oddgrd/sumodd/README.md

# Sumodd mini-sumo robot

Sumodd is a mini-sumo robot developed from scratch, including firmware in C, 3D modelling and PCB
design. See competition rules and robot requirements for mini-sumo robots
[here](https://robotex.international/wp-content/uploads/2025/11/Mini-sumo-rules-2025-ENG.pdf).

The idea for this project, the design of the firmware statemachine and some of the hardware
choices were inspired by [`artfulbytes`](https://github.com/artfulbytes) excellent
[youtube series](https://www.youtube.com/watch?v=g9KbXJydf8I) where he made a sumo robot
from scratch. See his project code [here](https://github.com/artfulbytes/nsumo_video).

## Documentation

The schematic and PCB layout KiCad files for the Sumodd motherboard are available in the
[sumodd-hardware repository](https://github.com/oddgrd/sumodd-hardware), with more detailed
documentation of the parts used and their layout on the board.

The 3D model for the sumo robot chassis, armor and other modules are created in Onshape, the
models for the current v03 version are publicly available
[here](https://cad.onshape.com/documents/0d7b7e5228d2e551c364e980/w/8961cb35e7c10a0739c2b909/e/27abdf6ed8f0cca5180f020e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).

Documentation of the robot's core functionality can be found in the docs directory, with scope
captures for illustration.

- [Firmware state machine](docs/state-machine.md)
- [Enemy detection with time of flight sensors](docs/ranging.md)
- [Dohyo border line detection](docs/line-detection.md)
- [Remote start IR signal handling](docs/ir-remote.md)
- [Motor control](docs/motor-control.md)

In addition to the above, we have a simple voltage divider battery voltage monitor, documented
in the [hardware repo](https://github.com/oddgrd/sumodd-hardware#battery-monitor). It will stop the
motors and indicate with a LED if the battery voltage is too low.

## Development

This project uses [`mise`](https://mise.jdx.dev/) to manage tools and commands/tasks. If you'd
rather not use it, inspect the `mise.toml` file to read which tools are required, and which
commands it runs.

For more information on command usage, append --help to a command, e.g. `mise run build --help`.
For an interactive overview of the available commands, run `mise run`.

### Firmware overview

- Our application code and our driver code lives in `app` and `app/drivers`.
- The STM32CubeMX generated source and header files live in `Src` and
`Inc`.
- External libraries live in `external`, at the time of writing it holds a Segger RTT library
git submodule, used for logging in debug builds, ST's VL53L4CD driver and the Unity unit testing
framework.
- Integration/HIL and unit tests live in `tests`.

We use the STM32 HAL to configure and interact with the hardware, and we use the
[STM32CubeMX](https://www.st.com/en/development-tools/stm32cubemx.html) software to generate the
hardware initialization code for GPIO, I2C, ADC etc., as well as the initial CMake configuration.

If you'd like to view or mutate the current configuration in CubeMX, simply initialize a project
from the `sumo.ioc` file in the root of this repo.

### Building

```sh
# Defaults to debug
mise run build

# Alternatively, specify build preset
mise run build release
```

### Flashing

To build, flash the firmware and reset the device:
```sh
# Build preset is required, defaults to debug
mise run flash
```

To build, flash, reset and attach an RTT logger to device:

```sh
# Build preset is required, defaults to debug
mise run launch
```

To reset the device:

```sh
mise run reset
```

To format the C application code with `clang-format`:

```sh
mise run reset
```

To lint the C application code with `cppcheck`:

```sh
mise run lint
```

### Debugging

To debug the firmware, first build it with the debug preset, then install the probe-rs vscode
[extension](https://marketplace.visualstudio.com/items?itemName=probe-rs.probe-rs-debugger).
You can now start a DAP debug session with probe-rs in the vscode debugging tab.

- To launch a new debug session, which flashes first and resets the device, run the VSCode debugger
with the `.vscode/launch.json` "probe-rs launch" configuration.
- Alternatively, to attach a debugger to a running device to inspect the current state, run the VS
Code debugger with the `.vscode/launch.json` "probe-rs attach" configuration

You can also view logs sent over RTT in debug or integration test builds:

```sh
# Build preset is required, defaults to debug
mise run log
```

### Flashing without probe-rs

The mise commands depend on probe-rs. If you don't want to use probe-rs for flashing and resetting,
you can convert the .elf file to an ARM binary, then flash with st-flash, or whichever other method
you prefer:

```sh
# Create the binary
arm-none-eabi-objcopy -O binary build/debug/sumo.elf build/debug/sumo.bin

# Flash it and reset the device
st-flash --reset write  build/debug/sumo.bin 0x08000000
```

## Testing

To run the unity unit tests, run: `mise run test`

To run the HIL tests, connect the device, then repeat the build and flash steps above, but use the
desired integration test cmake preset.

The currently existing integration test presets are:

- test-drive

For example, if you want to build, flash and attach a logger to an integration test, run:

```sh
mise run launch test-drive
```

## Diagrams

[PlantUML](https://plantuml.com/) is used for diagrams, it depends on Java, which mise manages.

To download the jar file for platuml: `mise run plantuml-setup`. The path it downloads to is set
in a mise variable, which may need to be adjusted to your local system.

To generate a UML png: `mise run plantuml-generate`. Defaults to state machine diagram UML.
