oddgrd/sumodd/docs/media/pcb-layout.png

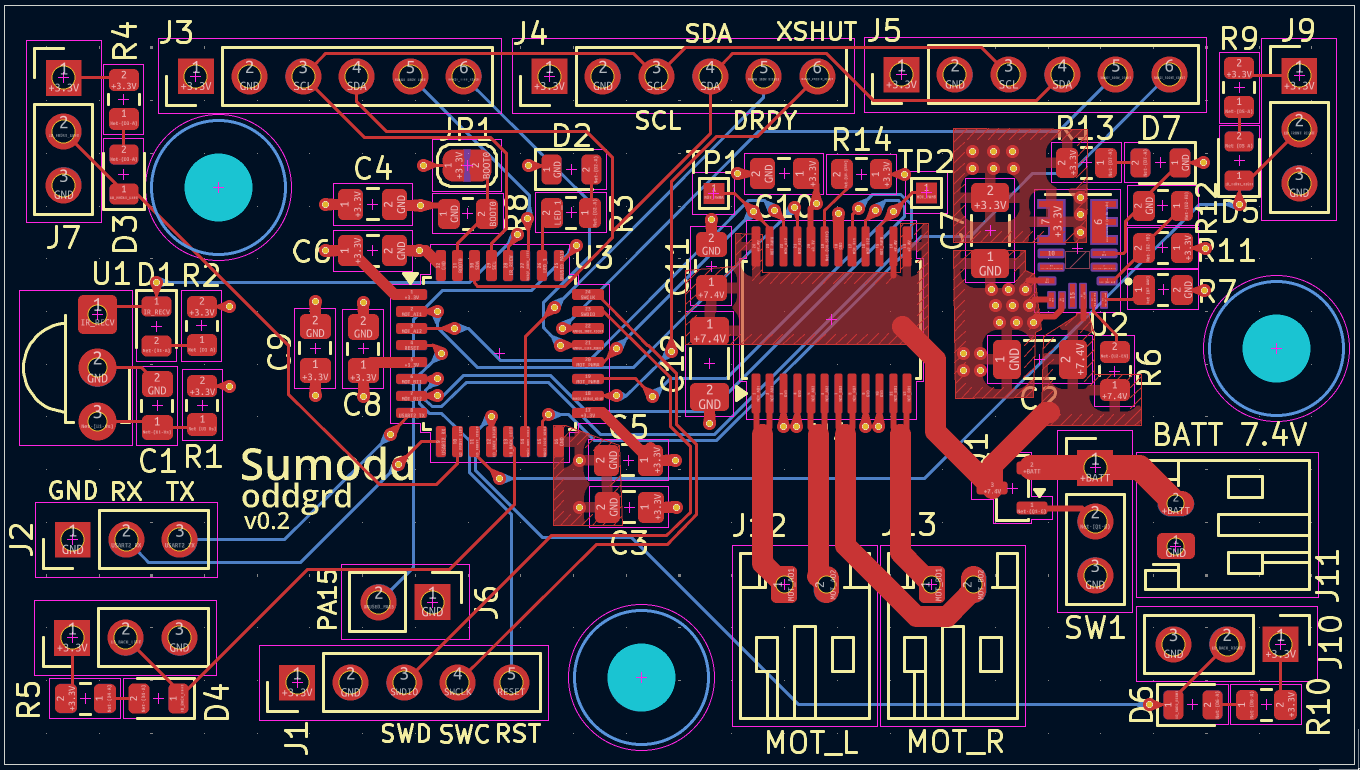
docs/media/pcb-layout.png
