oddgrd/sumodd/docs/media/sumodd-schematic-v03.png

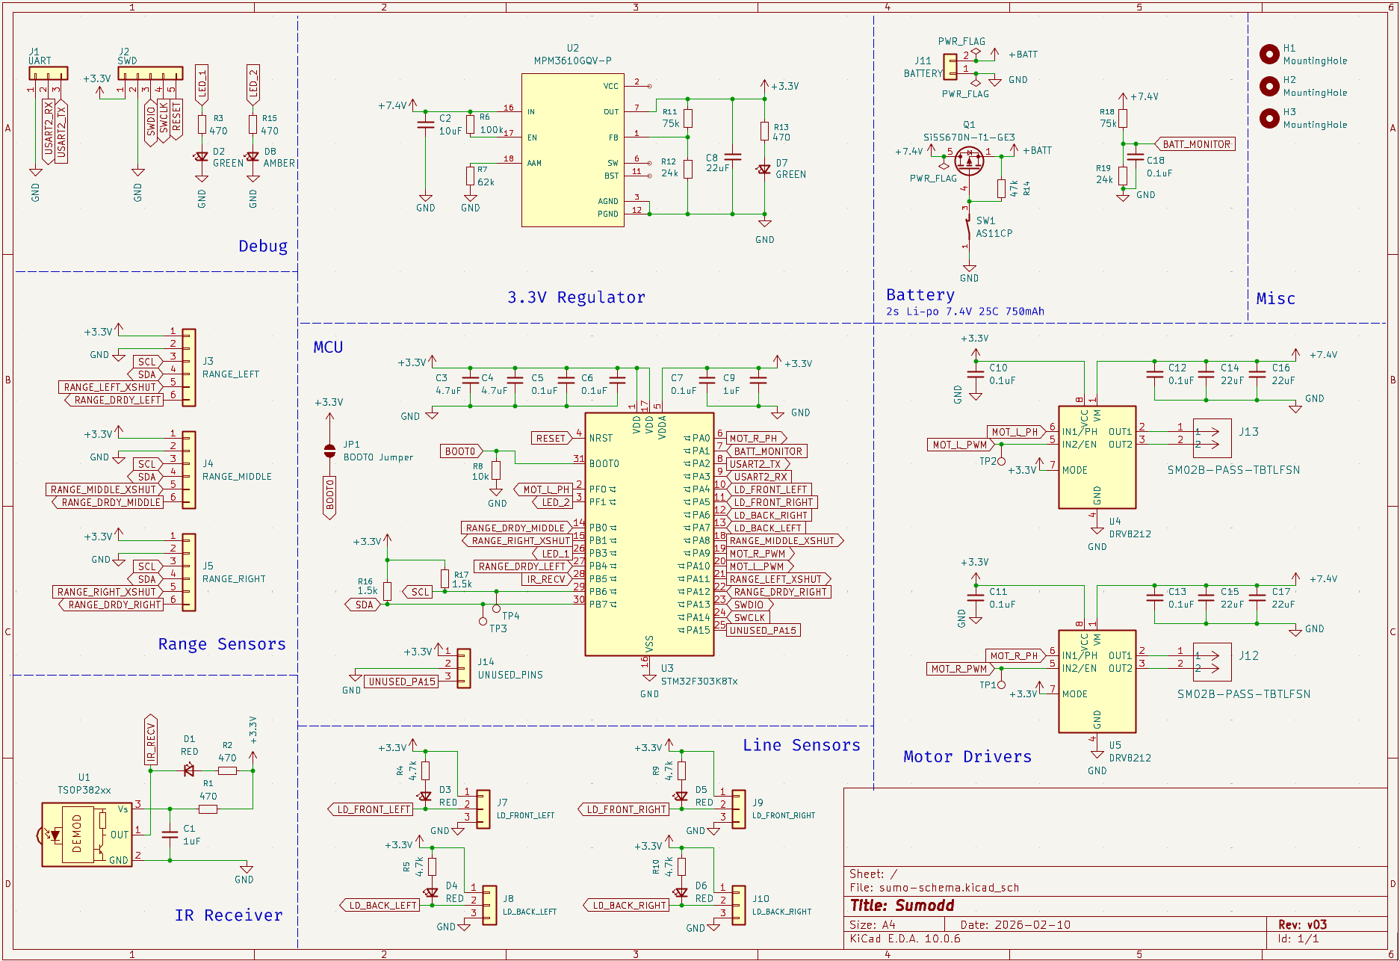
docs/media/sumodd-schematic-v03.png
