oddgrd/sumodd/sumo.ioc

Mcu.UserName=STM32F303K8Tx
PA0.Signal=GPIO_Output
PA1.Signal=ADC1_IN2
PA10.Signal=S_TIM2_CH4
PA11.Signal=GPIO_Output
PA12.Signal=GPXTI12
PA13.Signal=SYS_JTMS-SWDIO
PA14.Signal=SYS_JTCK-SWCLK
PA2.Signal=USART2_TX
PA3.Signal=USART2_RX
PA4.Signal=ADC2_IN1
PA5.Signal=ADC2_IN2
PA6.Signal=ADC2_IN3
PA7.Signal=ADC2_IN4
PA8.Signal=GPIO_Output
PA9.Signal=S_TIM2_CH3
PB0.Signal=GPXTI0
PB1.Signal=GPIO_Output
PB3.Signal=GPIO_Output
PB4.Signal=GPXTI4
PB5.Signal=S_TIM17_CH1
PB6.Signal=I2C1_SCL
PB7.Signal=I2C1_SDA
