oddgrd/sumodd/app/state_attack.c

#include "state_attack.h"

#include "drivers/motor_driver.h"
#include "main.h"
#include "state.h"

void state_attack_enter(struct StateAttackCtx *ctx, State from, StateEvent event)
{
    UNUSED(event);
    UNUSED(from);

    // TODO: switch on from, if we were already attacking in the same way, do nothing. Keep
    // previous attack direction in attack state.
    Enemy enemy = ctx->state_common->enemy;
    if (enemy.bearing == BEARING_FRONT)
    {
        motor_drive(70, DRIVE_FORWARD);
    }
    else if (enemy.bearing == BEARING_LEFT)
    {
        if (enemy.distance_mm > 100)
        {
            motor_drive(60, DRIVE_FORWARD_ARC_LEFT);
        }
        else
        {
            motor_drive(50, DRIVE_SPIN_LEFT);
        }
    }
    else if (enemy.bearing == BEARING_RIGHT)
    {
        if (enemy.distance_mm > 100)
        {
            motor_drive(60, DRIVE_FORWARD_ARC_RIGHT);
        }
        else
        {
            motor_drive(50, DRIVE_SPIN_RIGHT);
        }
    }
}
