oddgrd/sumodd/app/state_search.c

#include "state_search.h"

#include "drivers/motor_driver.h"
#include "main.h"
#include "state.h"

void state_search_enter(struct StateSearchCtx *ctx, State from, StateEvent event)
{
    motor_drive(50, DRIVE_SPIN_LEFT);

    UNUSED(event);
    UNUSED(from);
    UNUSED(ctx);
}
