oddgrd/sumodd/Src/tim.c

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
/* Includes ------------------------------------------------------------------*/
#include "tim.h"

TIM_HandleTypeDef htim1;
TIM_HandleTypeDef htim2;
TIM_HandleTypeDef htim17;

/* TIM1 init function */
void MX_TIM1_Init(void)
{

  /* USER CODE BEGIN TIM1_Init 0 */
  /**
   * This timer peripheral is used to emit TRG0 update events, which are used to trigger conversions
   * of all four channels in the ADC used for the line sensors. This is to control the frequency of
   * these conversions, rather than running continuous conversions.
   * TODO: This was done at a time when we were relying on the conversion interrupts and did not
   * want to spam them, but since we no longer use those, we just use DMA to update a buffer on
   * each conversion, we could consider dropping this timer and doing continuous conversions.
   */
  /* USER CODE END TIM1_Init 0 */

  TIM_ClockConfigTypeDef sClockSourceConfig = {0};
  TIM_MasterConfigTypeDef sMasterConfig = {0};

  /* USER CODE BEGIN TIM1_Init 1 */
  // With prescaler set to 64 (-1 because stm32 TIM prescalers are zero-based), and a source clock
  // of 64MHz, this timer will have a frequency of 1MHz, which means each tick is 1us. With the
  // period set to 100, the timer will reload and trigger an update event every 100us. That update
  // event will trigger a conversion in the line sensor ADC.
  /* USER CODE END TIM1_Init 1 */
  htim1.Instance = TIM1;
  htim1.Init.Prescaler = 63;
  htim1.Init.CounterMode = TIM_COUNTERMODE_UP;
  htim1.Init.Period = 100;
  htim1.Init.ClockDivision = TIM_CLOCKDIVISION_DIV1;
  htim1.Init.RepetitionCounter = 0;
  htim1.Init.AutoReloadPreload = TIM_AUTORELOAD_PRELOAD_DISABLE;
  if (HAL_TIM_Base_Init(&htim1) != HAL_OK)
  {
    Error_Handler();
  }
  sClockSourceConfig.ClockSource = TIM_CLOCKSOURCE_INTERNAL;
  if (HAL_TIM_ConfigClockSource(&htim1, &sClockSourceConfig) != HAL_OK)
  {
    Error_Handler();
  }
  sMasterConfig.MasterOutputTrigger = TIM_TRGO_UPDATE;
  sMasterConfig.MasterOutputTrigger2 = TIM_TRGO2_RESET;
  sMasterConfig.MasterSlaveMode = TIM_MASTERSLAVEMODE_DISABLE;
  if (HAL_TIMEx_MasterConfigSynchronization(&htim1, &sMasterConfig) != HAL_OK)
  {
    Error_Handler();
  }
}
/* TIM2 init function */
void MX_TIM2_Init(void)
{

  /* USER CODE BEGIN TIM2_Init 0 */
  // Timer used for controlling the speed of each motor, generating PWM output on two separate
  // channels.
  /* USER CODE END TIM2_Init 0 */

  TIM_MasterConfigTypeDef sMasterConfig = {0};
  TIM_OC_InitTypeDef sConfigOC = {0};

  /* USER CODE BEGIN TIM2_Init 1 */
  /**
   * With the system clock running at 64MHz, we configure the period and prescaler to arrive at
   * 20KHz frequency:
   * f_PWM = f_TIM / ((PSC + 1)(ARR + 1))
   * f_PWM = 64MHz / (32 * 100)
   * f_PWM = 20KHz
   */
  /* USER CODE END TIM2_Init 1 */
  htim2.Instance = TIM2;
  htim2.Init.Prescaler = 31;
  htim2.Init.CounterMode = TIM_COUNTERMODE_UP;
  htim2.Init.Period = 100 - 1;
  htim2.Init.ClockDivision = TIM_CLOCKDIVISION_DIV1;
  htim2.Init.AutoReloadPreload = TIM_AUTORELOAD_PRELOAD_DISABLE;
  if (HAL_TIM_PWM_Init(&htim2) != HAL_OK)
  {
    Error_Handler();
  }
  sMasterConfig.MasterOutputTrigger = TIM_TRGO_RESET;
  sMasterConfig.MasterSlaveMode = TIM_MASTERSLAVEMODE_DISABLE;
  if (HAL_TIMEx_MasterConfigSynchronization(&htim2, &sMasterConfig) != HAL_OK)
  {
    Error_Handler();
  }
  sConfigOC.OCMode = TIM_OCMODE_PWM1;
  sConfigOC.Pulse = 0;
  sConfigOC.OCPolarity = TIM_OCPOLARITY_HIGH;
  sConfigOC.OCFastMode = TIM_OCFAST_DISABLE;
  if (HAL_TIM_PWM_ConfigChannel(&htim2, &sConfigOC, TIM_CHANNEL_3) != HAL_OK)
  {
    Error_Handler();
  }
  if (HAL_TIM_PWM_ConfigChannel(&htim2, &sConfigOC, TIM_CHANNEL_4) != HAL_OK)
  {
    Error_Handler();
  }
  HAL_TIM_MspPostInit(&htim2);

}
/* TIM17 init function */
void MX_TIM17_Init(void)
{

  /* USER CODE BEGIN TIM17_Init 0 */
  // This timer is primarily used for input capture of IR remote NEC signal pulses, which are then
  // decoded in the drivers/ir_remote.c driver.
  //
  // Its secondary purpose is supporting a microsecond delay function, since ST's HAL only
  // provides a millisecond delay. Since this timer is prescaled to 1 MHz, it is easy to use for
  // that purpose.
  /* USER CODE END TIM17_Init 0 */

  TIM_IC_InitTypeDef sConfigIC = {0};

  htim17.Instance = TIM17;
  htim17.Init.Prescaler = 64 - 1;
  htim17.Init.CounterMode = TIM_COUNTERMODE_UP;
  htim17.Init.Period = 65536 - 1;
  htim17.Init.ClockDivision = TIM_CLOCKDIVISION_DIV1;
  htim17.Init.RepetitionCounter = 0;
  htim17.Init.AutoReloadPreload = TIM_AUTORELOAD_PRELOAD_DISABLE;
  if (HAL_TIM_Base_Init(&htim17) != HAL_OK)
  {
    Error_Handler();
  }
  if (HAL_TIM_IC_Init(&htim17) != HAL_OK)
  {
    Error_Handler();
  }
  sConfigIC.ICPolarity = TIM_INPUTCHANNELPOLARITY_FALLING;
  sConfigIC.ICSelection = TIM_ICSELECTION_DIRECTTI;
  sConfigIC.ICPrescaler = TIM_ICPSC_DIV1;
  sConfigIC.ICFilter = 0;
  if (HAL_TIM_IC_ConfigChannel(&htim17, &sConfigIC, TIM_CHANNEL_1) != HAL_OK)
  {
    Error_Handler();
  }
}

void HAL_TIM_Base_MspInit(TIM_HandleTypeDef* tim_baseHandle)
{

  GPIO_InitTypeDef GPIO_InitStruct = {0};
  if(tim_baseHandle->Instance==TIM1)
  {
    /* TIM1 clock enable */
    __HAL_RCC_TIM1_CLK_ENABLE();

    /* TIM1 interrupt Init */
    HAL_NVIC_SetPriority(TIM1_TRG_COM_TIM17_IRQn, 0, 0);
    HAL_NVIC_EnableIRQ(TIM1_TRG_COM_TIM17_IRQn);
  }
  else if(tim_baseHandle->Instance==TIM17)
  {
    /* TIM17 clock enable */
    __HAL_RCC_TIM17_CLK_ENABLE();

    __HAL_RCC_GPIOB_CLK_ENABLE();
    /**TIM17 GPIO Configuration
    PB5     ------> TIM17_CH1
    */
    GPIO_InitStruct.Pin = GPIO_PIN_5;
    GPIO_InitStruct.Mode = GPIO_MODE_AF_PP;
    GPIO_InitStruct.Pull = GPIO_NOPULL;
    GPIO_InitStruct.Speed = GPIO_SPEED_FREQ_LOW;
    GPIO_InitStruct.Alternate = GPIO_AF10_TIM17;
    HAL_GPIO_Init(GPIOB, &GPIO_InitStruct);

    /* TIM17 interrupt Init */
    HAL_NVIC_SetPriority(TIM1_TRG_COM_TIM17_IRQn, 0, 0);
    HAL_NVIC_EnableIRQ(TIM1_TRG_COM_TIM17_IRQn);
  }
}

void HAL_TIM_PWM_MspInit(TIM_HandleTypeDef* tim_pwmHandle)
{

  if(tim_pwmHandle->Instance==TIM2)
  {
    /* TIM2 clock enable */
    __HAL_RCC_TIM2_CLK_ENABLE();
  }
}
void HAL_TIM_MspPostInit(TIM_HandleTypeDef* timHandle)
{

  GPIO_InitTypeDef GPIO_InitStruct = {0};
  if(timHandle->Instance==TIM2)
  {
    __HAL_RCC_GPIOA_CLK_ENABLE();
    /**TIM2 GPIO Configuration
    PA9     ------> TIM2_CH3
    PA10     ------> TIM2_CH4
    */
    GPIO_InitStruct.Pin = GPIO_PIN_9|GPIO_PIN_10;
    GPIO_InitStruct.Mode = GPIO_MODE_AF_PP;
    GPIO_InitStruct.Pull = GPIO_NOPULL;
    GPIO_InitStruct.Speed = GPIO_SPEED_FREQ_LOW;
    GPIO_InitStruct.Alternate = GPIO_AF10_TIM2;
    HAL_GPIO_Init(GPIOA, &GPIO_InitStruct);

  }

}

void HAL_TIM_Base_MspDeInit(TIM_HandleTypeDef* tim_baseHandle)
{

  if(tim_baseHandle->Instance==TIM1)
  {
    /* Peripheral clock disable */
    __HAL_RCC_TIM1_CLK_DISABLE();

    /* TIM1 interrupt Deinit */
  /* USER CODE BEGIN TIM1:TIM1_TRG_COM_TIM17_IRQn disable */
    /**
     * Uncomment the line below to disable the "TIM1_TRG_COM_TIM17_IRQn" interrupt
     * Be aware, disabling shared interrupt may affect other IPs
     */
    /* HAL_NVIC_DisableIRQ(TIM1_TRG_COM_TIM17_IRQn); */
  /* USER CODE END TIM1:TIM1_TRG_COM_TIM17_IRQn disable */

  }
  else if(tim_baseHandle->Instance==TIM17)
  {
    /* Peripheral clock disable */
    __HAL_RCC_TIM17_CLK_DISABLE();

    /**TIM17 GPIO Configuration
    PB5     ------> TIM17_CH1
    */
    HAL_GPIO_DeInit(GPIOB, GPIO_PIN_5);

    /* TIM17 interrupt Deinit */
  /* USER CODE BEGIN TIM17:TIM1_TRG_COM_TIM17_IRQn disable */
    /**
     * Uncomment the line below to disable the "TIM1_TRG_COM_TIM17_IRQn" interrupt
     * Be aware, disabling shared interrupt may affect other IPs
     */
    /* HAL_NVIC_DisableIRQ(TIM1_TRG_COM_TIM17_IRQn); */
  /* USER CODE END TIM17:TIM1_TRG_COM_TIM17_IRQn disable */

  }
}

void HAL_TIM_PWM_MspDeInit(TIM_HandleTypeDef* tim_pwmHandle)
{

  if(tim_pwmHandle->Instance==TIM2)
  {
    /* Peripheral clock disable */
    __HAL_RCC_TIM2_CLK_DISABLE();
  }
}
