oddgrd/sumodd/app/drivers/ir_remote.h

#pragma once

#include <stdbool.h>
#include <stdint.h>

#include "main.h"

/**
 * @brief Decoded NECx frame.
 */
typedef struct
{
    uint16_t addr;
    uint8_t cmd;
    uint8_t cmd_inverted;
} NecxDecoded;

typedef enum
{
    IR_NONE,
    IR_START, // 0x10
    IR_STOP,  // 0x11
} IrCommand;

/**
 * @brief Initialize the IR remote driver.
 *
 * Start the input capture timer peripheral, and initialize the interrupt handler.
 */
void ir_remote_init(void);

/**
 * @brief Fetch an IR command from the IR remote queue, if any have been received.
 */
IrCommand ir_remote_get_cmd(void);
