oddgrd/sumodd/app/ring_buffer.c

#include "ring_buffer.h"

#include <stdbool.h>
#include <stdint.h>
#include <string.h>

void ring_buffer_init(RingBuffer *rb, uint8_t *buffer, uint32_t capacity, uint32_t element_size)
{
    rb->capacity = capacity;
    rb->element_size = element_size;
    rb->head = 0;
    rb->tail = 0;
    rb->data = buffer;
}

// TODO: UNSAFE! Disable IRQ at start of function, restore after, to ensure single producer.
void ring_buffer_push(RingBuffer *rb, const void *item)
{
    uint32_t head = rb->head;

    // TODO: better comment, move to header file?
    // Since the buffer wraps, we cannot just check if (head - tail) == capacity. And we don't want
    // to track a count of elements, because that is unsafe, it would need to be mutated by both
    // producers and consumers.
    //
    // We also cannot check if head == tail to determine if the queue is full, because that is what
    // we do to check for empty.
    // Therefore, we check for empty with head == tail, and we check for full with
    // (head + 1) & (rb->capacity - 1), checking if another write would make head == tail.
    // When the buffer is full, deny new writes. When new reads are made, the queue will no longer
    // be full, and accept writes again.
    uint32_t next_head = (head + 1) & (rb->capacity - 1);

    // If the buffer is full, drop the oldest event by incrementing the tail.
    if (next_head == rb->tail)
    {
        rb->tail = (rb->tail + 1) & (rb->capacity - 1);
    }

    // TODO: consider compiler barrier? To ensure write happens before head advances in other ISR.
    // rb->data is a pointer to a byte buffer, so indexing it moves it by single bytes, but we may
    // need multiple bytes per element, so we multiply by element size.
    memcpy(&rb->data[head * rb->element_size], item, rb->element_size);

    rb->head = next_head;
}

// Called from main loop only
bool ring_buffer_pop(RingBuffer *rb, void *item)
{
    uint32_t tail = rb->tail;

    if (tail == rb->head)
    {
        return false;
    }

    // TODO: consider compiler barrier? To ensure read happens before tail advances in other ISR.
    memcpy(item, &rb->data[tail * rb->element_size], rb->element_size);

    // Equivalent to modulo as long as the capacity is a power of two.
    // Examples with capacity 8:
    // (3 + 1) & (8 - 1)
    // 00000100 & 00000111 = 00000100 // no wrap, set to 4
    // -----------------
    // (7 + 1) & (8 - 1)
    // 00001000 & 00000111 = 00000000 // reached capacity, wrap to 0
    rb->tail = (tail + 1) & (rb->capacity - 1);
    return true;
}

bool ring_buffer_is_empty(const RingBuffer *rb)
{
    return rb->tail == rb->head;
}
