oddgrd/sumodd/(commit log)

2026-01-25 enable uart and printf logging
    this is blocking and inefficient, refactor to non-blocking DMA based uart tx later
2026-01-25 set up probe-rs vscode debug launch config
2026-02-01 simplify and fix nec decoding
    [nec_capture.c, nec_capture.h]
2026-02-07 implement adc watchdog line sensing poc, ring buffer, doxygen comments
2026-02-07 correctly handle nec address bytes
    [app_config.h, nec_capture.c, ring_buffer.c, ring_buffer.h]
2026-02-14 motor driver poc
2026-02-15 move line sensor adc wd, state into separate modules
2026-02-15 switch up pins to make room for all peripherals
2026-02-28 replace adc wd with adc 4 channel scan with dma
    [line_sensor.c, line_sensor.h, state.c, state.h, sumo.ioc]
2026-03-01 vl53lox driver i2c init and gpio config
2026-03-16 uart dma config
2026-03-16 pin configuration for 4x motors, 3x vl53
    remove motor driver stby output pin, pull it high to vcc instead
2026-03-27 fix motor pwm prescaler bug
    [motor_driver.c, state.c]
2026-04-05 state machine refactor, re-enable retreat timer
2026-04-11 refactor state machine to act on current input, improve motor api
2026-04-13 implement RTT logging with segger rtt lib, disable uart dma
2026-04-18 implement vl53l0x driver/api from ST
    vl53l0x_platform.c was heavily modified to work with my hal, rather than with windows dynamic libs, as it was configured from ST. It's working now, but needs to be refactored to support multiple sensors on one bus, data ready interrupts on extio, hidden behind a ranging API and implemented in the searching state.
2026-04-18 initial ranging module with init function
    includes poc ranging co
    initialize all sensors in init function, pulling xshut low to set distinct I2C device addresses for all, and configuring all with falling edge interrupts on the gpio pin
2026-04-29 reduce to two ranging sensors, ranging state update function
2026-04-30 implement in-place target tracking with range sensors
    also reduce motor driver pwm period to 100, retaining the 20kHz frequency, to simplify setting the motor speed
2026-05-27 implement target following
    tracks a target with range sensors, drives up to it, then stops
2026-05-29 switch to plantuml for state diagram
2026-05-31 make ranging sensors less sensitive to noise/weak signals
    [ranging.c]
2026-06-04 speed estimation script, cleanup, deny C warnings
    the denial of C warnings is particularly useful, if we don't set a default for enum switches, and not all variants are covered, a warning is emitted, which now fails compilation, giving us a poor mans exhaustive match statements
    [ranging.c]
2026-06-04 setup cppcheck mise task, resolve lints
    [ranging.c, ranging.h, state.c, state.h, state_retreat.c, state_search.c]
2026-06-06 fix adc crosstalk bug, push target in attack, increase speed
    [line_sensor.c, state.c, state_attack.c, state_retreat.c]
2026-06-06 simplify and clean up timer and adc dma config
    disable unused PWM no-output channel on line sensors timer, disable unused interrupts on adc dma
2026-06-28 enable the middle tof sensor, set vl53l0x noise filtering and sigma back to defaults
    We initially set this to combat the false positive detections, but those were caused by the uneven arena, and were resolved by angling the sensors slightly upwards. We set them back to defaults, but keep the explicit setting, so that we can easily adjust them in high ambient light conditions. We also document them further.
    [ranging.c, ranging.h]
2026-07-05 add attach probe-rs debug config, reorganize readme
2026-07-06 expand and refine the motor control docs
2026-07-09 add schematic and pcb screenshots
2026-09-05 docs: update readme link, schematic image
2026-09-12 feat: implement lint and unit test ci, extend mise tools manifest (#1)
    - Implement basic CI with unit test running and cppcheck linting.
    - Correctly git add the rtt submodule.
    - Commit the stm32cubemx generated drivers files, that were previously gitignored. They are needed for tests, and for reproducible builds of the project, without needing to run stm32cubemx to generate them.
2026-09-12 feat: tweak drive speeds & arc turn width, clamp speed input
2026-09-26 feat: update motor driver to work with new drv8212 drivers
2026-09-26 feat: microsecond delay utility, use it to wake drivers with minimal delay
    As suggested by ST: https://community.st.com/stm32-mcus-products-25/stm32g030-microsecond-delay-125293
2026-09-26 chore: let stm32cubemx format its generated code
2026-10-05 feat: implement VL53L4CD ULD driver, remove VL53L0X driver (#3)
    * feat: add st's VL53L4CD ULD driver, empty platform integration
    * feat: implement vl53l4cd platform functions, update app ranging functions
    * feat: enable i2c fast mode plus
    * feat: remove vl53l0x driver files
    This reduced flash usage in release builds from 38% to 25% (25KB to 16KB), and ram usage from 33% to 18% (4.1KB to 2.2KB)
    * feat: re-enable all ranging sensors
    * feat: ignore non-zero status ranging data
2026-10-05 fix: adapt motor driver to motor connection, line sensor adc config
    The motors were not connected symmetrically, so the driver needs to account for that until we can re-solder. The line sensor ADC config was not correctly updated in cubemx before being moved in 1323462, only one channel was used, now all four are used.
    [adc.c, motor_driver.c, sumo.ioc]
2026-10-06 docs: update ranging docs to vl53l4cd, auge pcbs
2026-10-06 docs: refactor main readme, update motor control to v03
2026-10-24 feat: implement firmware for new ADC battery monitor (#6)
    * feat: implement battery voltage reading at regular intervals
    Triggering a conversion every 500ms with TIM6 update event, and then reading the ADC value after the conversion with an ADC1 ISR.
    * feat: enter shutdown on low voltage over threshold duration
    Furthermore, indicate the failure with the new yellow debug LED on PF1.
    * feat: use central config in ranging
2026-10-24 docs: battery monitor documentation
