oddgrd/sumodd/(notices)

Notices in the files:
Src/tim.c:
Copyright (c) 2026 STMicroelectronics.
All rights reserved.
